PyCubed-Mini/kicad-libs/README.md

# kicad-libs
KiCad libraries for REx Lab avionics
