PyCubed-Mini/kicad-libs/3d/OV5640-A Camera.step

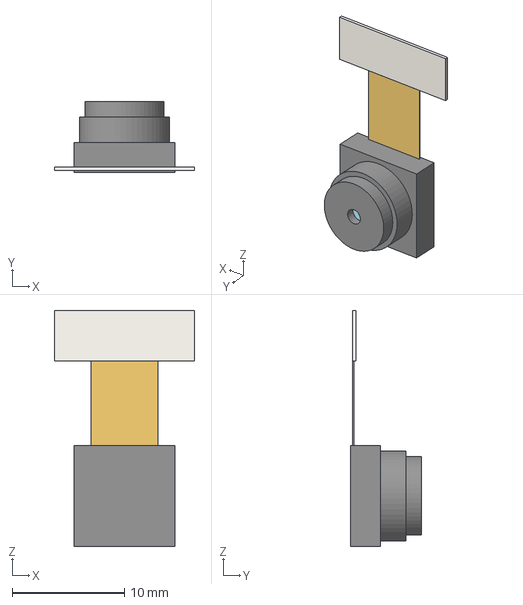
[picture p1: CAD file, 2023-06-18]
3d/OV5640-A Camera.step
12.5 x 6.32 x 21.0 mm
