PyCubed-Mini/kicad-libs/3d/SM141K05TF.step

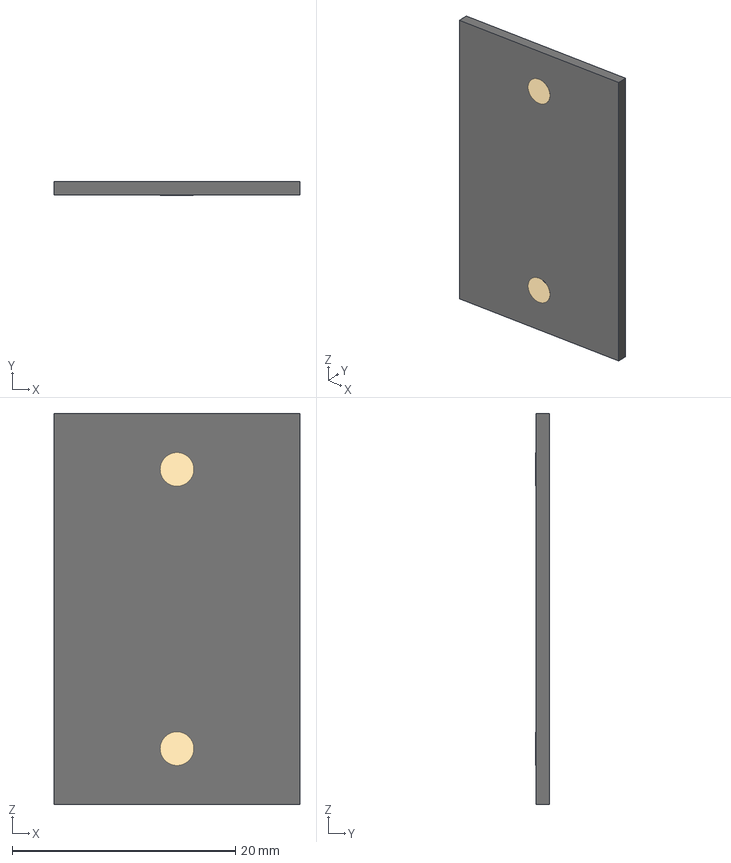
[picture p2: CAD file, 2023-05-28]
3d/SM141K05TF.step
22.0 x 1.22 x 35.0 mm
