PyCubed-Mini/kicad-libs/3d/SOT-583.stp

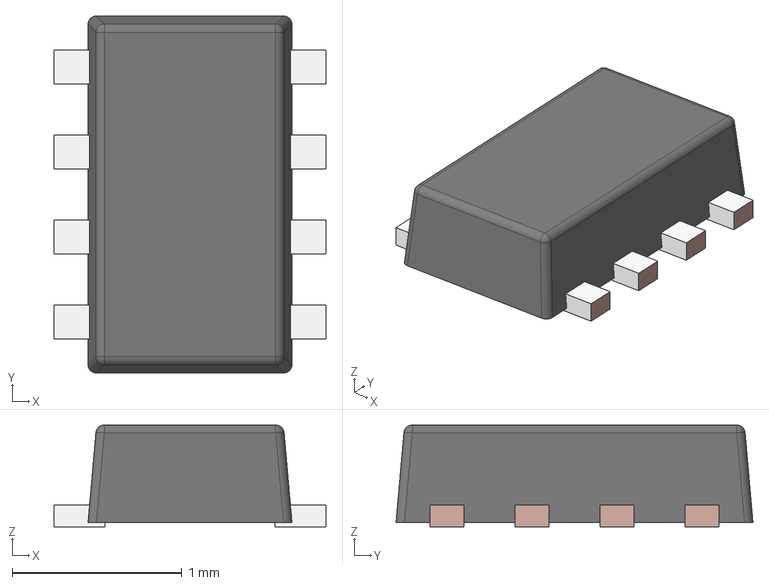
[picture p3: CAD file, 2023-05-28]
3d/SOT-583.stp
1.60 x 2.10 x 0.6 mm
FRAME-DRL0008A
BODY-SOT
