PyCubed-Mini/kicad-libs/3d/SM101K07L v1.step

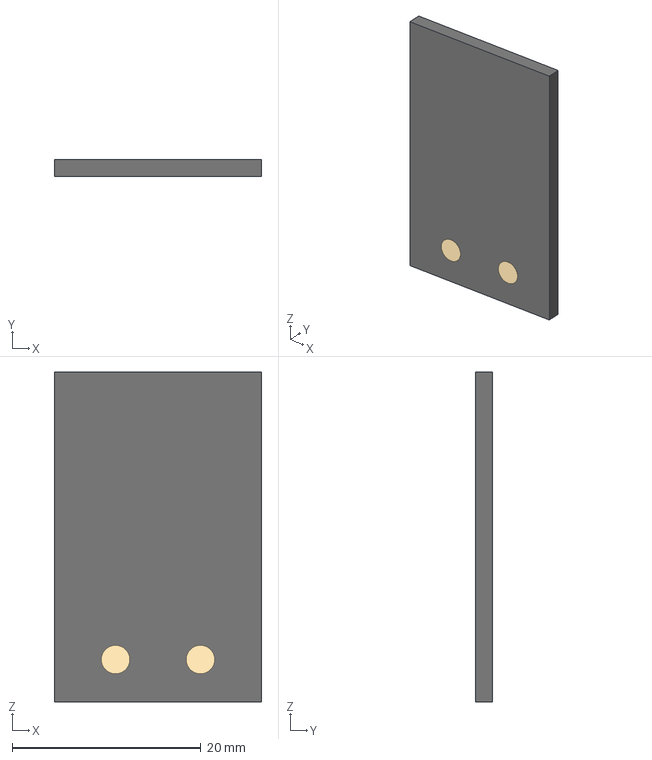
[picture p4: CAD file, 2023-05-28]
3d/SM101K07L v1.step
22.0 x 1.82 x 35.0 mm
