PyCubed-Mini/kicad-libs/3d/SM141K10LV v1.step

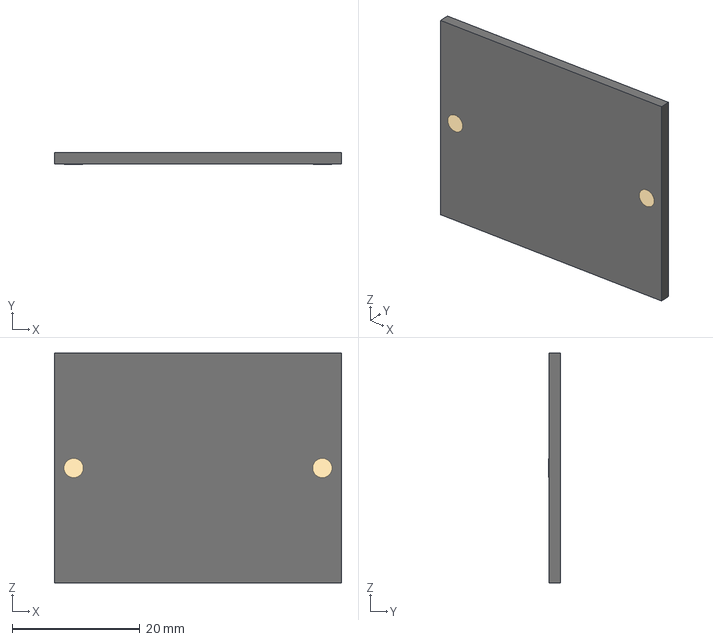
[picture p5: CAD file, 2023-05-28]
3d/SM141K10LV v1.step
45.0 x 1.82 x 36.0 mm
