PyCubed-Mini/kicad-libs/3d/Micro SD Card.STEP

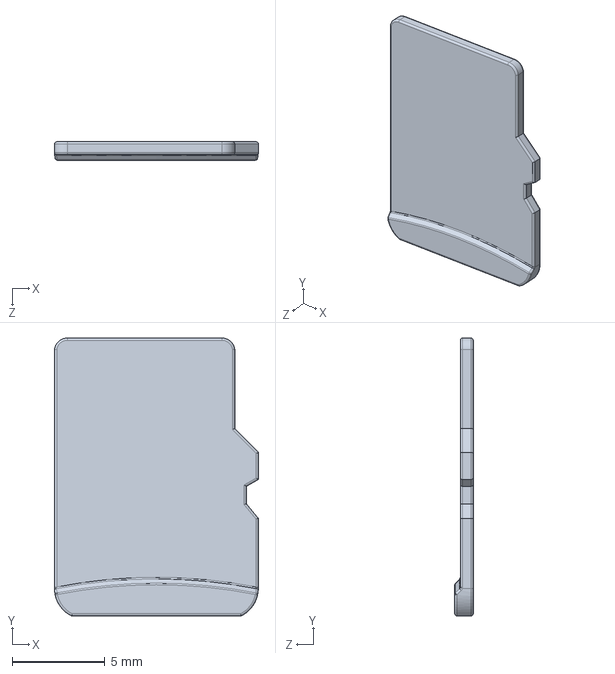
[picture p6: CAD file, 2023-02-25]
3d/Micro SD Card.STEP
11.0 x 15.0 x 1.00 mm
