PyCubed-Mini/kicad-libs/3d/OPT3001.step

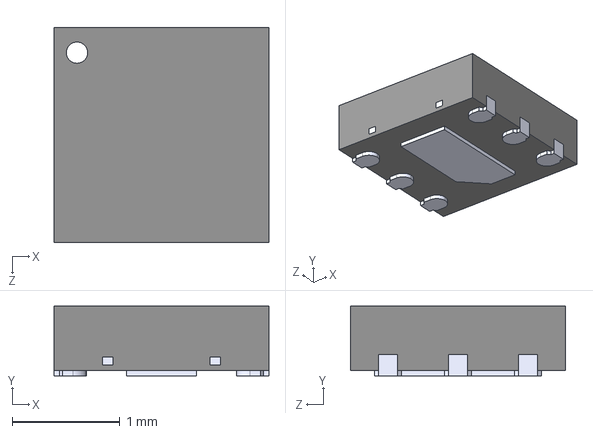
[picture p7: CAD file, 2023-02-25]
3d/OPT3001.step
2.00 x 0.65 x 2.00 mm
