PyCubed-Mini/kicad-libs/3d/BH1750FVI-TR.stp

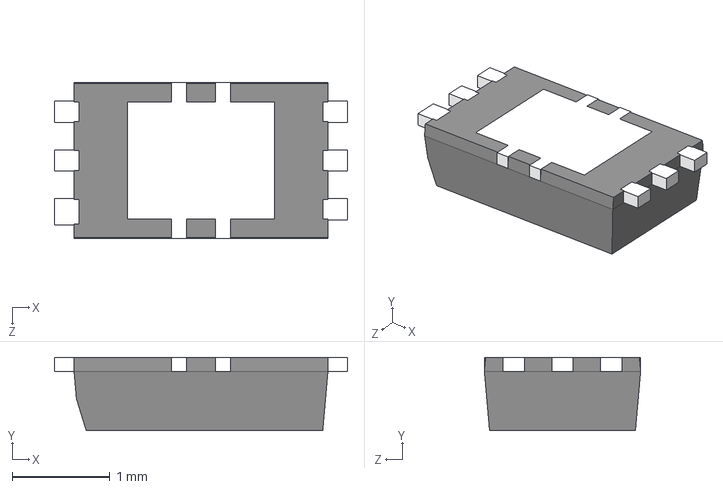
[picture p9: CAD file, 2023-02-19]
3d/BH1750FVI-TR.stp
3.00 x 0.75 x 1.60 mm
