PyCubed-Mini/kicad-libs/3d/SK6812-SIDE.step

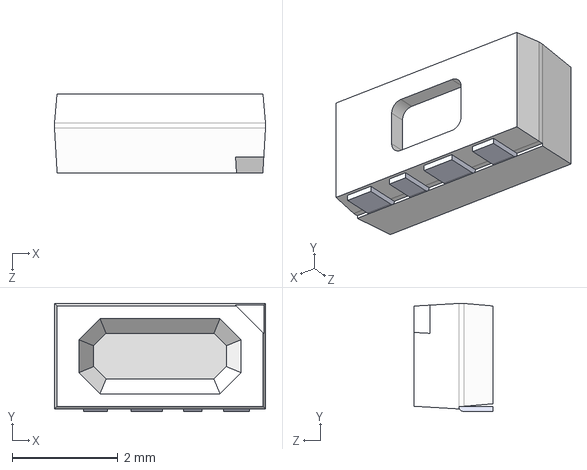
[picture p10: CAD file, 2023-02-18]
3d/SK6812-SIDE.step
4.00 x 2.05 x 1.50 mm
