PyCubed-Mini/kicad-libs/3d/KMS2.STEP

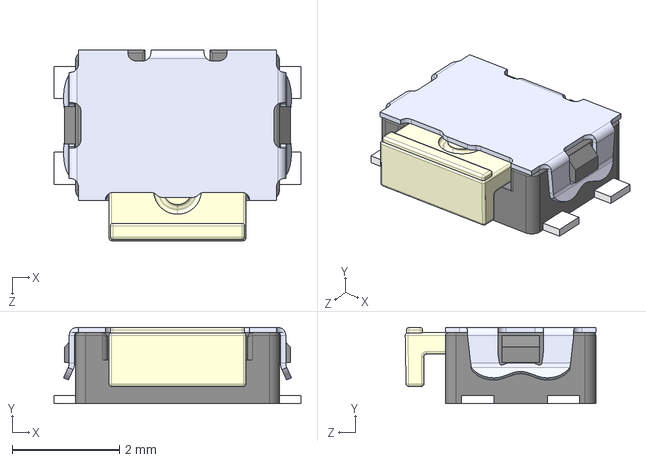
[picture p11: CAD file, 2023-02-18]
3d/KMS2.STEP
4.60 x 1.42 x 3.55 mm
