PyCubed-Mini/kicad-libs/3d/BNO085.step

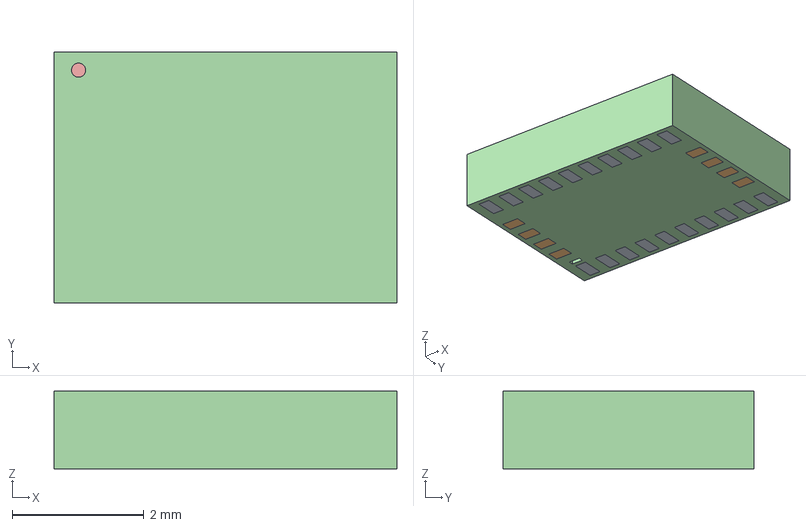
[picture p12: CAD file, 2023-02-18]
3d/BNO085.step
5.20 x 3.80 x 1.18 mm
