PyCubed-Mini/kicad-libs/3d/OV5640 Camera v1.step

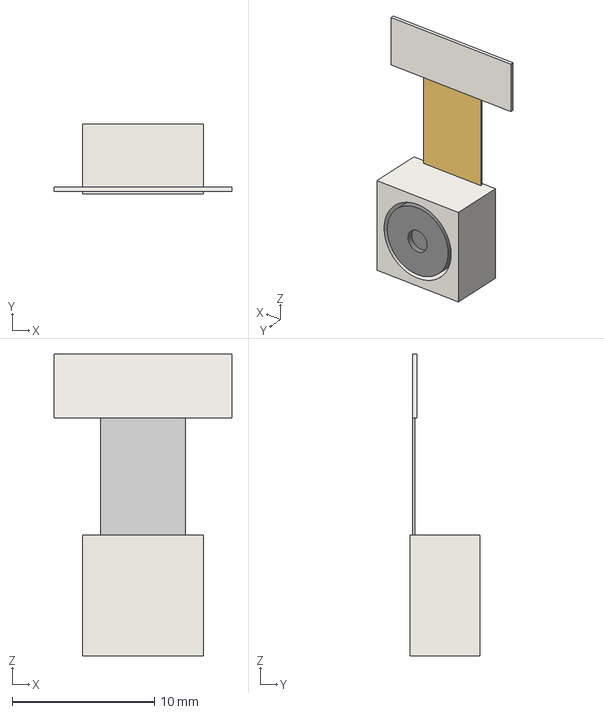
[picture p13: CAD file, 2023-02-09]
3d/OV5640 Camera v1.step
12.5 x 4.95 x 21.2 mm
