PyCubed-Mini/kicad-libs/3d/Crystal_4pin_2520.STEP

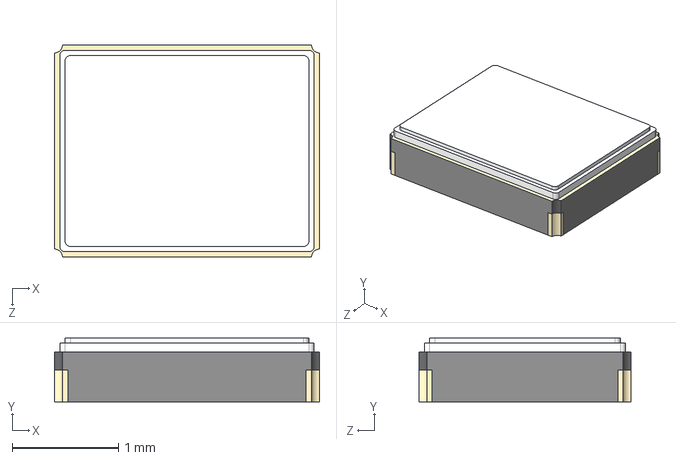
[picture p14: CAD file, 2023-02-08]
3d/Crystal_4pin_2520.STEP
2.50 x 0.6 x 2.00 mm
