PyCubed-Mini/kicad-libs/3d/CAS-120TA.stp

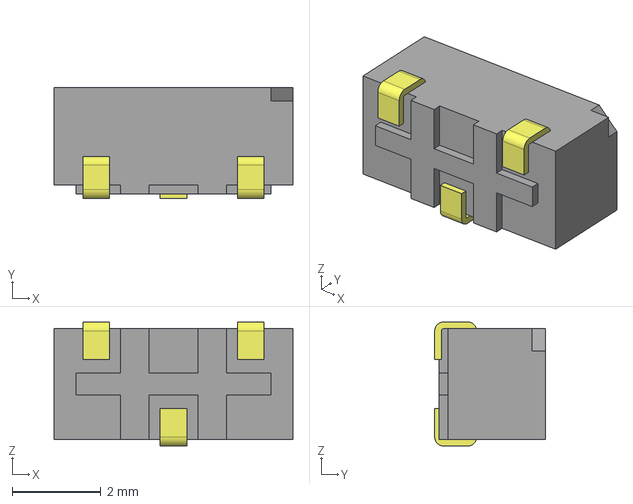
[picture p15: CAD file, 2023-02-08]
3d/CAS-120TA.stp
5.40 x 2.50 x 2.80 mm
1 pole_s
CAS_c_12A
