PyCubed-Mini/kicad-libs/3d/FTS-105-01-X-DV-A.stp

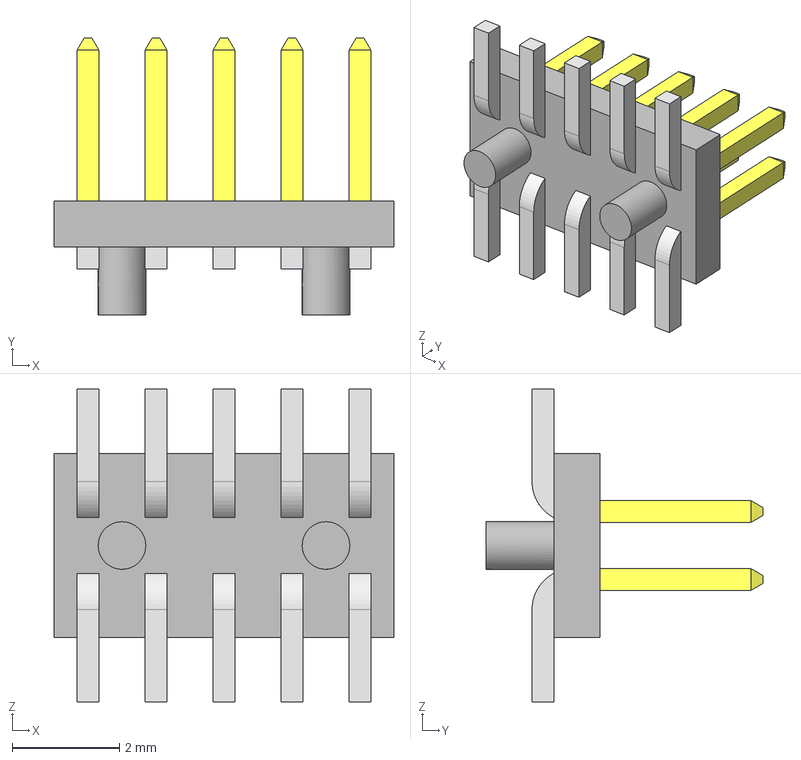
[picture p16: CAD file, 2022-11-09]
3d/FTS-105-01-X-DV-A.stp
6.35 x 5.18 x 5.84 mm
FTS-105-01-L-DV-A_pins2
FTS-105-01-L-DV-A_pins1
FTS-105-01-L-DV-A_body
