PyCubed-Mini/kicad-libs/3d/B3U-3000P.STEP

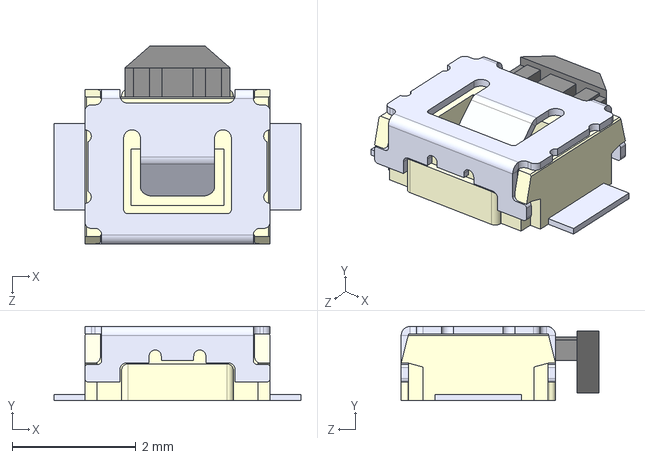
[picture p17: CAD file, 2022-11-09]
3d/B3U-3000P.STEP
4.00 x 1.20 x 3.20 mm
