PyCubed-Mini/kicad-libs/3d/FLE-107-01-X-DV-A.stp

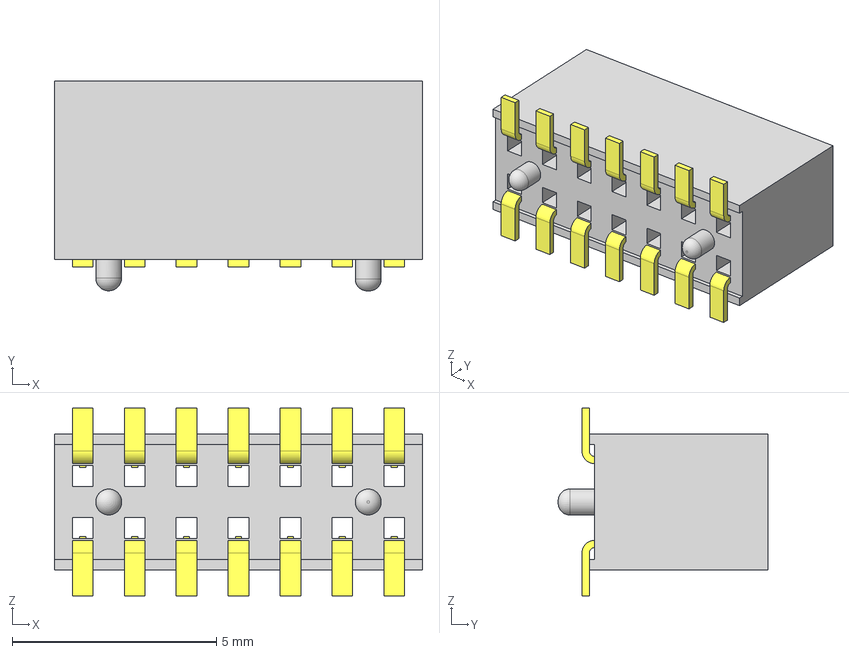
[picture p18: CAD file, 2022-10-09]
3d/FLE-107-01-X-DV-A.stp
9.00 x 5.13 x 4.59 mm
C-96-01-07-DV
FLE-107-01-DV-A_socket
