PyCubed-Mini/kicad-libs/3d/FTS-107-01-X-DV-A.stp

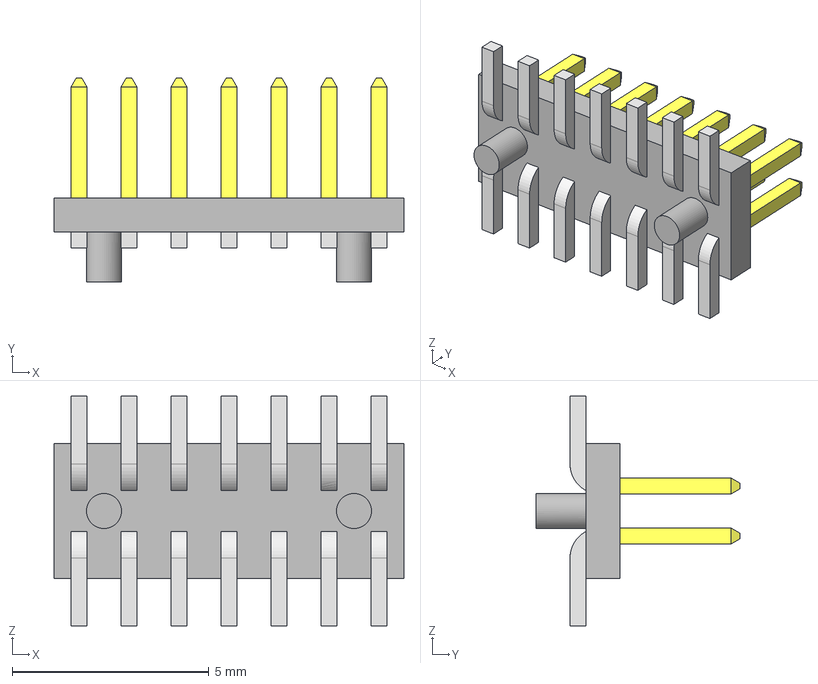
[picture p19: CAD file, 2022-10-09]
3d/FTS-107-01-X-DV-A.stp
8.89 x 5.18 x 5.84 mm
FTS-107-01-L-DV-A_pins2
FTS-107-01-L-DV-A_pins1
FTS-107-01-L-DV-A_body
