PyCubed-Mini/kicad-libs/3d/FTS-110-01-X-DV-A.stp

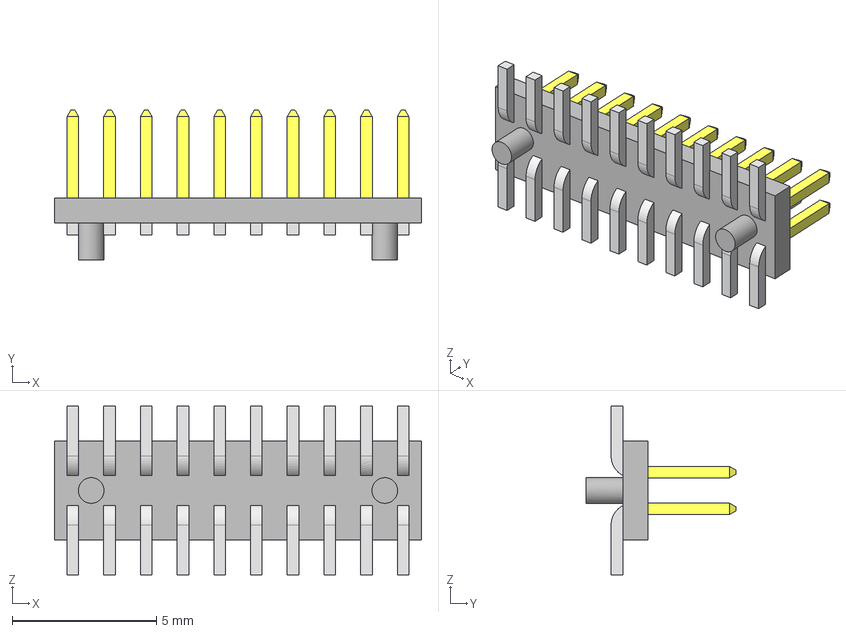
[picture p20: CAD file, 2022-08-21]
3d/FTS-110-01-X-DV-A.stp
12.7 x 5.18 x 5.84 mm
FTS-110-01-L-DV-A_pins2
FTS-110-01-L-DV-A_pins1
FTS-110-01-L-DV-A_body
