PyCubed-Mini/kicad-libs/3d/SFC-110-T2-X-D-A.step

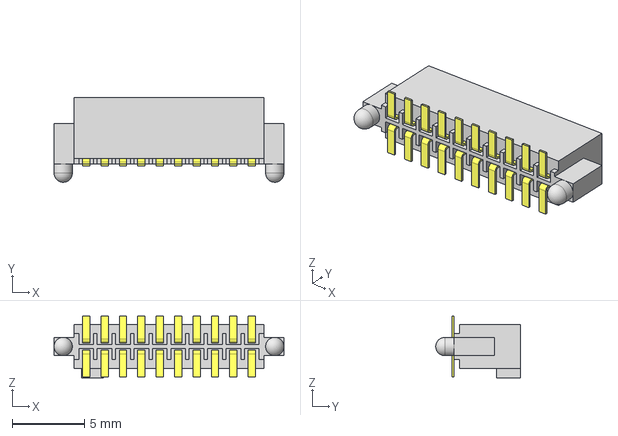
[picture p21: CAD file, 2022-08-20]
3d/SFC-110-T2-X-D-A.step
15.9 x 5.84 x 4.25 mm
C-119-T2-10_pins
SFC-110-T2-D-A_terminal
