PyCubed-Mini/kicad-libs/3d/LIS3MDLTR.step

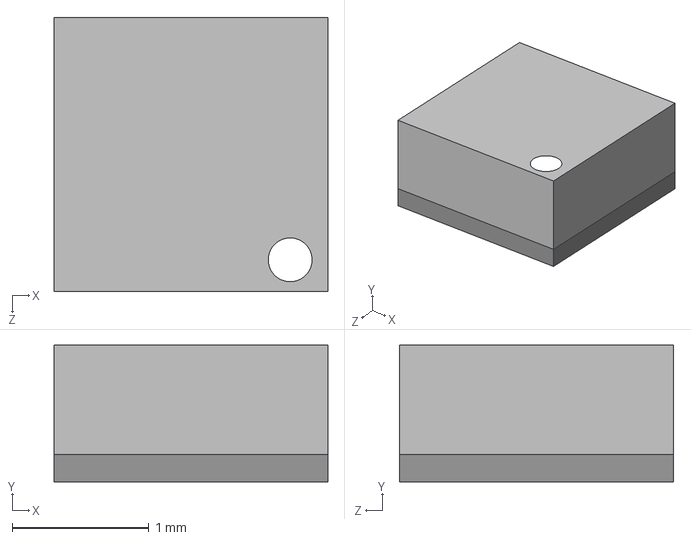
[picture p22: CAD file, 2022-08-20]
3d/LIS3MDLTR.step
2.00 x 1.00 x 2.00 mm
