PyCubed-Mini/kicad-libs/3d/LSM6DSOX.step

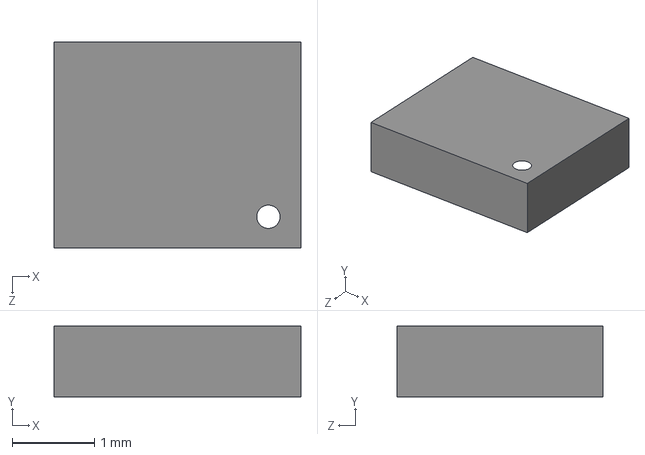
[picture p23: CAD file, 2022-08-20]
3d/LSM6DSOX.step
3.00 x 0.86 x 2.50 mm
