PyCubed-Mini/kicad-libs/3d/FTSH-110-01-X-DV-A.stp

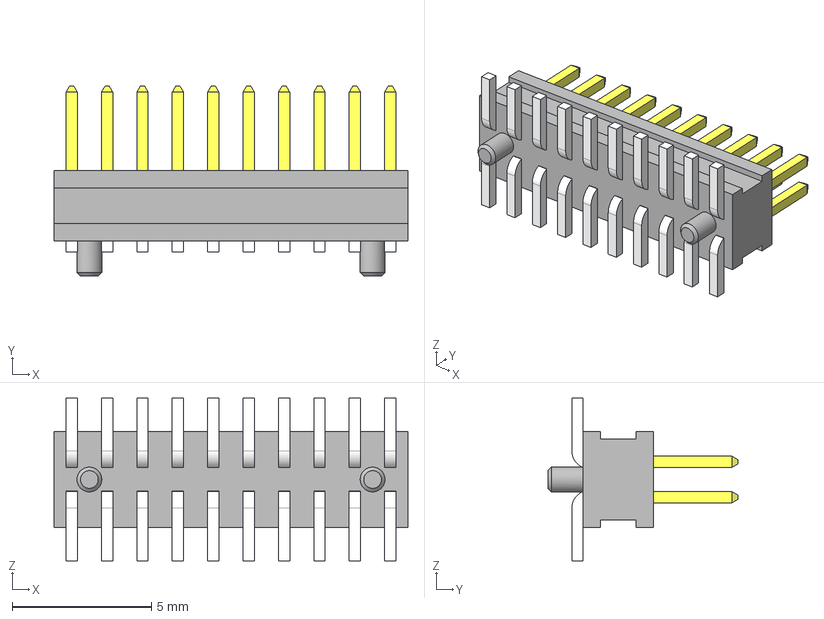
[picture p24: CAD file, 2022-08-20]
3d/FTSH-110-01-X-DV-A.stp
12.7 x 6.83 x 5.84 mm
FTSH-110-01-L-DV-A_pins2
FTSH-110-01-L-DV-A_pins1
FTSH-110-01-L-DV-A_body
