PyCubed-Mini/kicad-libs/3d/CLP-105-02-X-DH-A.stp

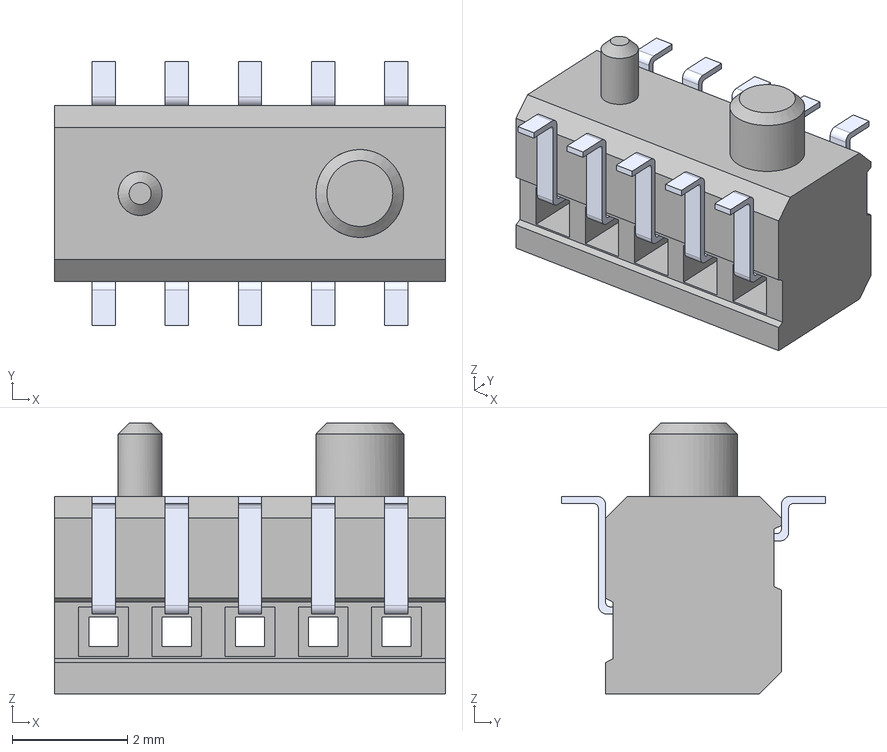
[picture p25: CAD file, 2022-08-20]
3d/CLP-105-02-X-DH-A.stp
6.78 x 4.57 x 4.70 mm
C-70-05-105-A_Pin_dh
C-70-04-105_Pin_2_dh
CLP-105-2-F-DH-A_terminal
