PyCubed-Mini/kicad-libs/3d/FLE-110-01-X-DV-A.step

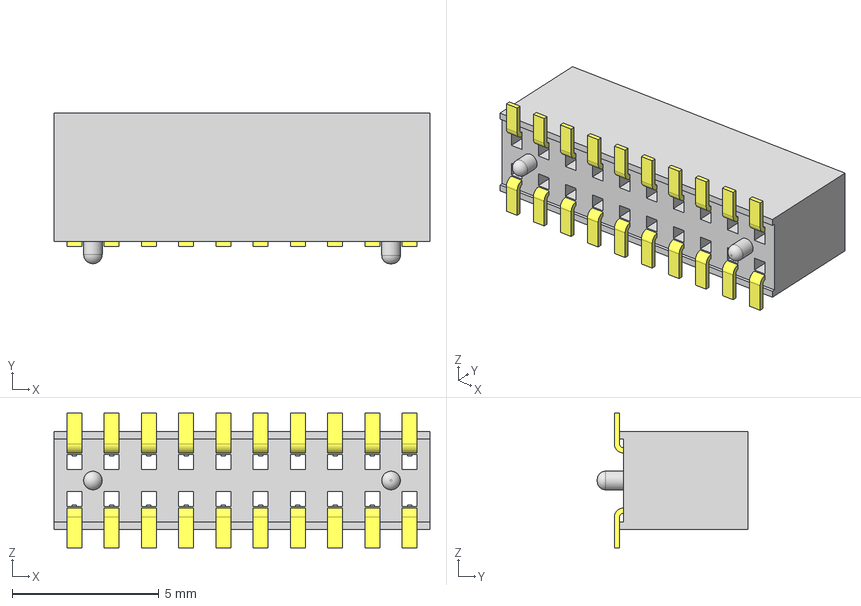
[picture p26: CAD file, 2022-08-20]
3d/FLE-110-01-X-DV-A.step
12.8 x 5.13 x 4.59 mm
C-96-01-10-DV
FLE-110-01-DV-A_socket
