PyCubed-Mini/kicad-libs/3d/BM02B-SRSS-TB.STEP

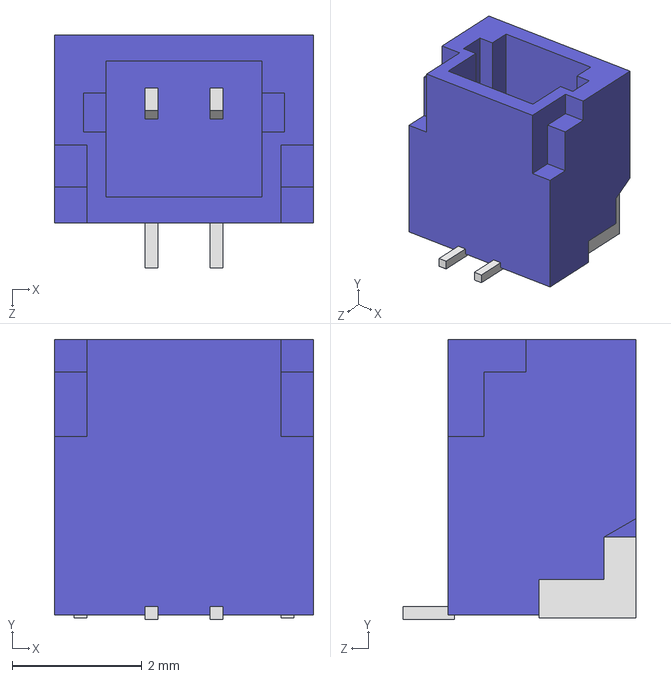
[picture p27: CAD file, 2022-07-05]
3d/BM02B-SRSS-TB.STEP
4.00 x 4.32 x 3.60 mm
