PyCubed-Mini/kicad-libs/3d/D2F_L2_A.step

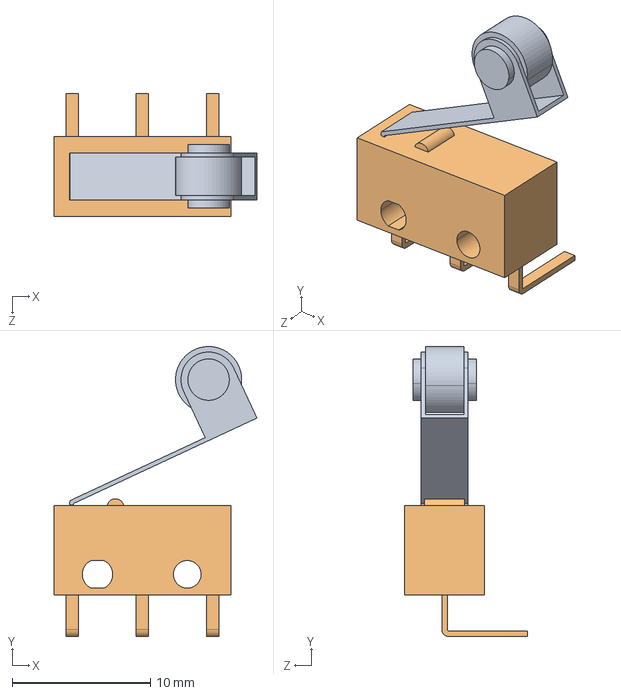
[picture p28: CAD file, 2022-07-04]
3d/D2F_L2_A.step
14.7 x 21.0 x 8.90 mm
D2F_L2_A_ACTUATOR
D2F_L2_A_BASE
