PyCubed-Mini/kicad-libs/3d/FLE-105-01-X-DV-A.step

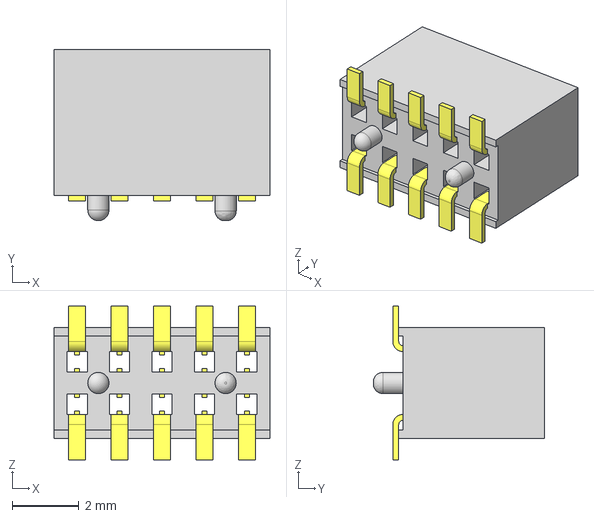
[picture p29: CAD file, 2022-06-29]
3d/FLE-105-01-X-DV-A.step
6.46 x 5.13 x 4.59 mm
_FLE-105-01-DV-A_socket
_C-96-01-05-DV
