PyCubed-Mini/kicad-libs/3d/TFM-110-12-X-D-A.stp

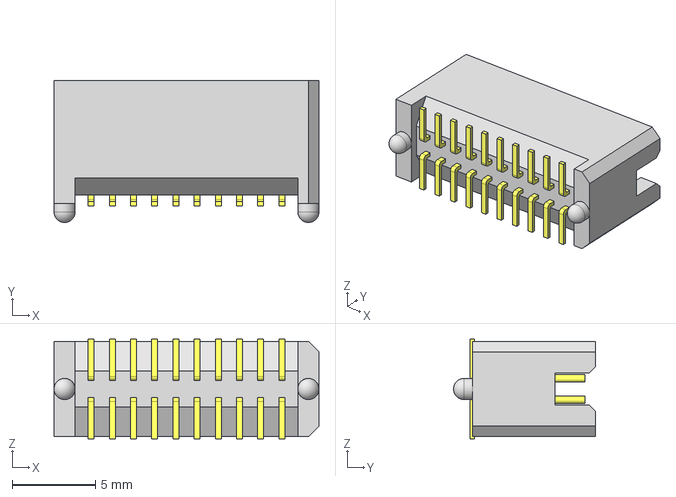
[picture p30: CAD file, 2022-06-08]
3d/TFM-110-12-X-D-A.stp
15.9 x 8.51 x 5.97 mm
_TFM-110-12-L-D-A_terminal
_TFM-110-12-L-D_pins
