PyCubed-Mini/kicad-libs/3d/PCM12SMTR.step

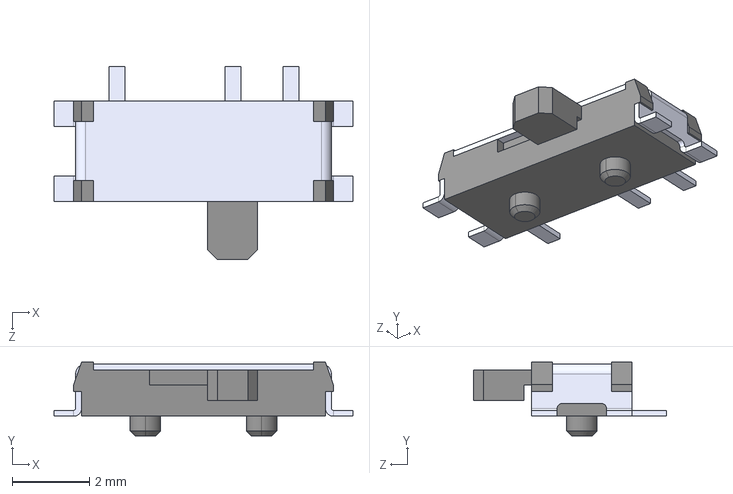
[picture p31: CAD file, 2022-06-08]
3d/PCM12SMTR.step
7.72 x 1.91 x 4.98 mm
