PyCubed-Mini/kicad-libs/3d/SFMC-110-01-X-D.stp

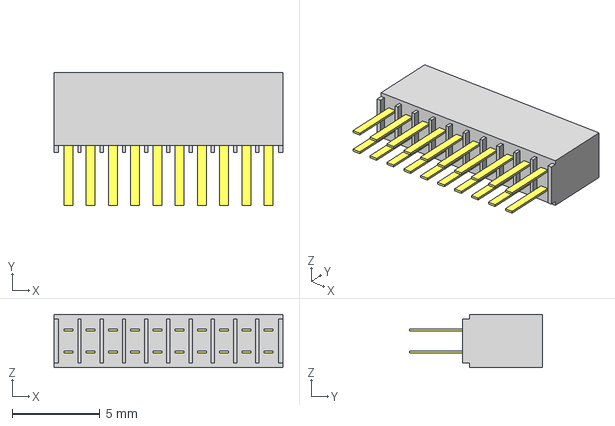
[picture p32: CAD file, 2022-06-08]
3d/SFMC-110-01-X-D.stp
13.1 x 7.62 x 3.05 mm
_SFMC-110-01_socket
_C-10-01_spins
