PyCubed-Mini/kicad-libs/3d/HRO_TYPE-C-31-M-12.step

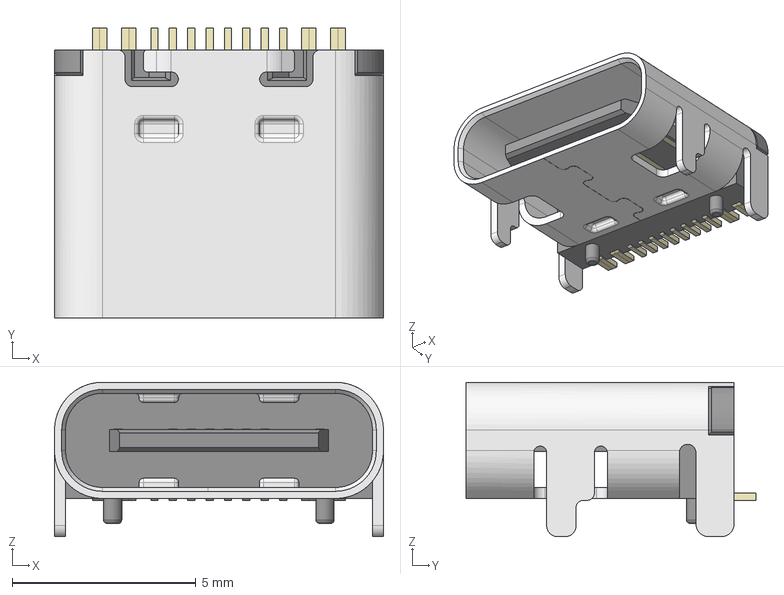
[picture p33: CAD file, 2022-05-17]
3d/HRO_TYPE-C-31-M-12.step
8.95 x 7.90 x 4.20 mm
