PyCubed-Mini/kicad-libs/3d/KMR221GLF.STEP

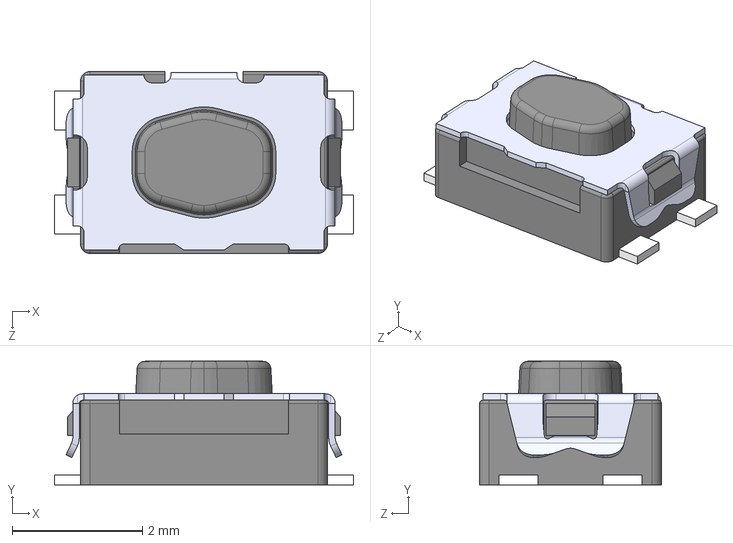
[picture p34: CAD file, 2022-05-14]
3d/KMR221GLF.STEP
4.60 x 1.90 x 2.80 mm
