PyCubed-Mini/kicad-libs/3d/nicla_vision.step

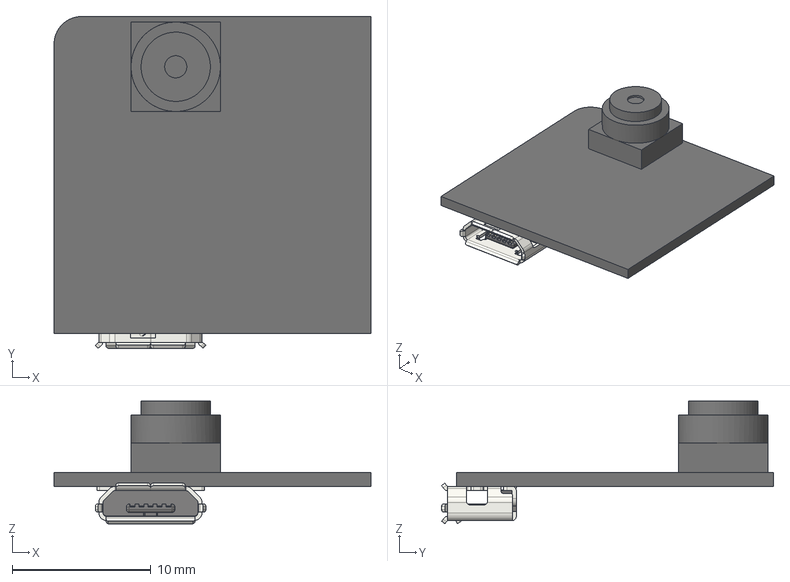
[picture p35: CAD file, 2022-03-25]
3d/nicla_vision.step
22.9 x 23.9 x 8.84 mm
