PyCubed-Mini/kicad-libs/3d/B2B-PH-SM4-TB(LF)(SN).STEP

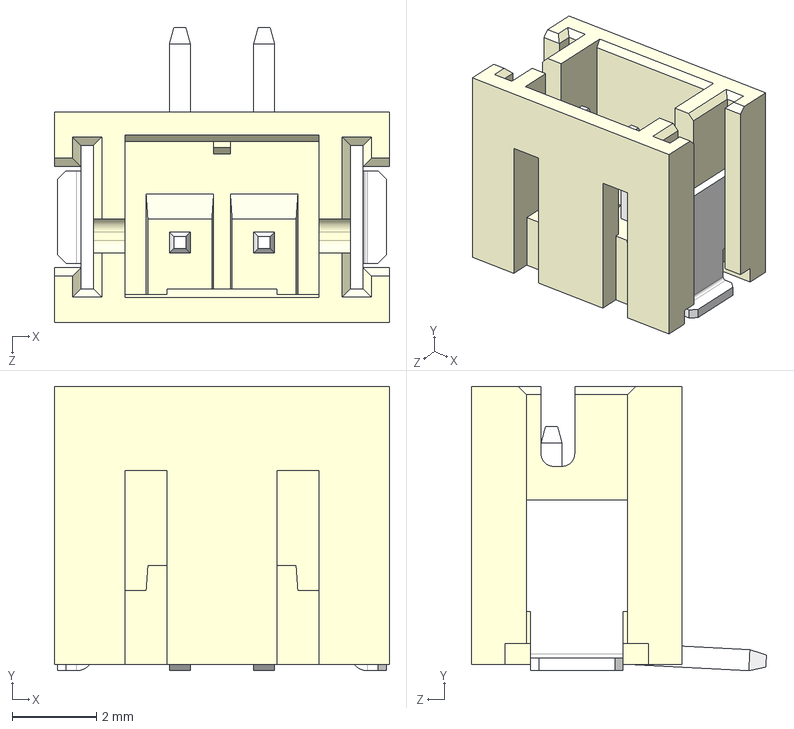
[picture p36: CAD file, 2022-03-14]
3d/B2B-PH-SM4-TB(LF)(SN).STEP
7.95 x 6.75 x 7.00 mm
