PyCubed-Mini/kicad-libs/3d/ATB2012-50011-T000.stp

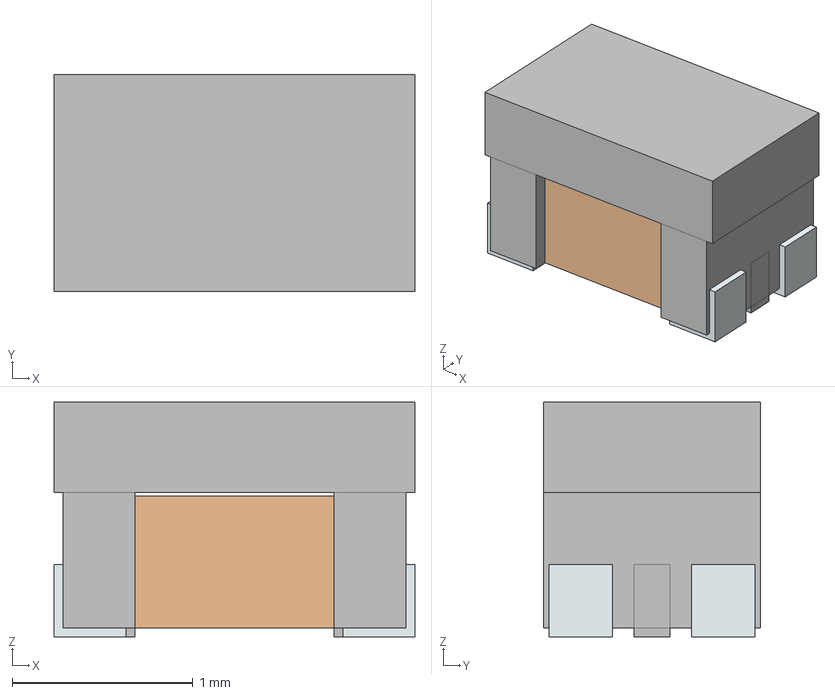
[picture p37: CAD file, 2022-03-14]
3d/ATB2012-50011-T000.stp
2.00 x 1.20 x 1.30 mm
solidBody
solidLead
solidCoil
