PyCubed-Mini/kicad-libs/3d/POWERDI-123.STEP

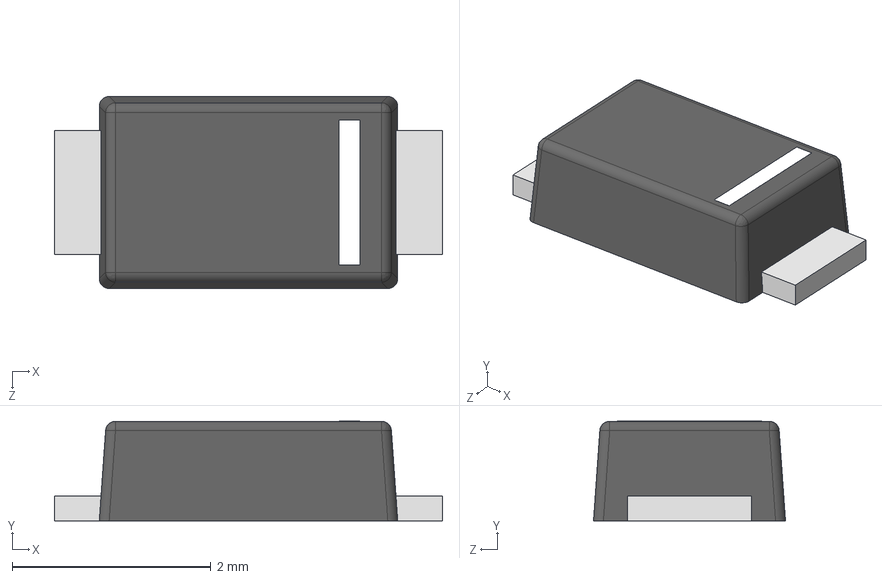
[picture p38: CAD file, 2022-03-14]
3d/POWERDI-123.STEP
3.90 x 1.00 x 1.93 mm
