PyCubed-Mini/kicad-libs/3d/MSS1P4-M3-89A.step

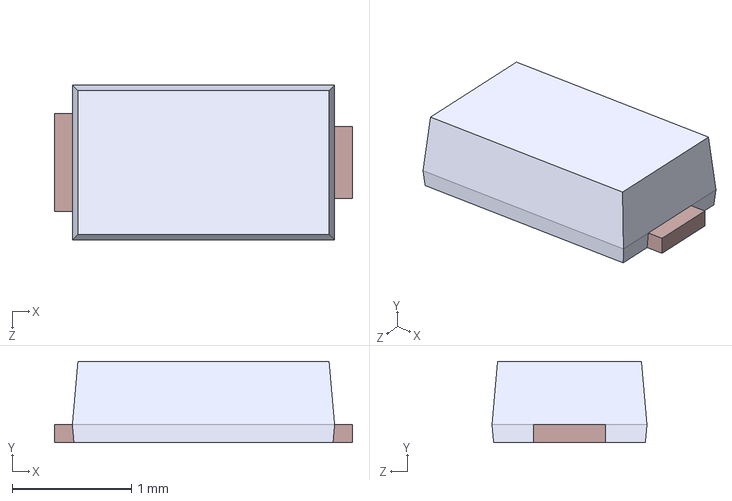
[picture p39: CAD file, 2022-03-14]
3d/MSS1P4-M3-89A.step
2.50 x 0.68 x 1.30 mm
