PyCubed-Mini/kicad-libs/3d/Coilcraft-LPS4018.step

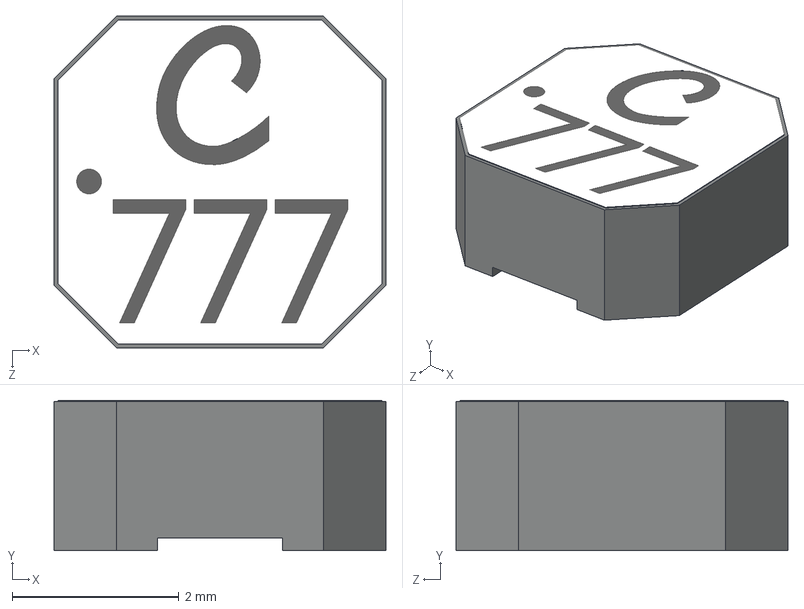
[picture p40: CAD file, 2022-03-14]
3d/Coilcraft-LPS4018.step
3.98 x 1.80 x 3.98 mm
