PyCubed-Mini/kicad-libs/3d/RFM98PW.step

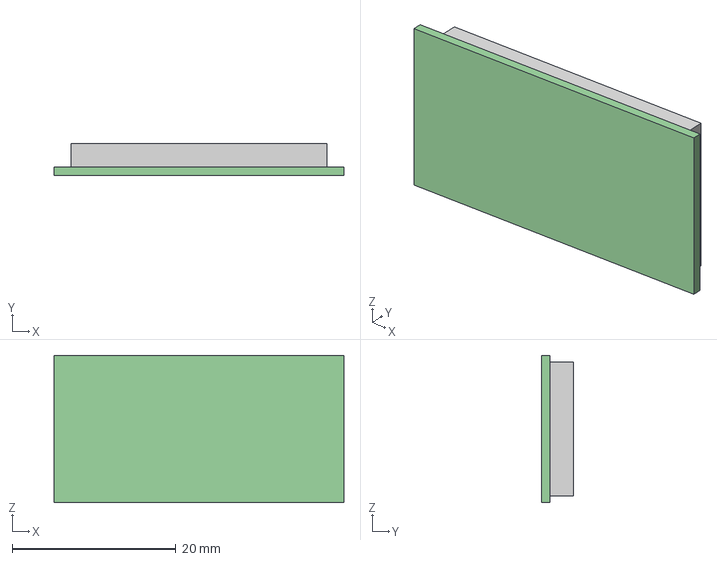
[picture p41: CAD file, 2022-03-04]
3d/RFM98PW.step
35.4 x 3.85 x 18.0 mm
