PyCubed-Mini/kicad-libs/3d/TSL2561.stp

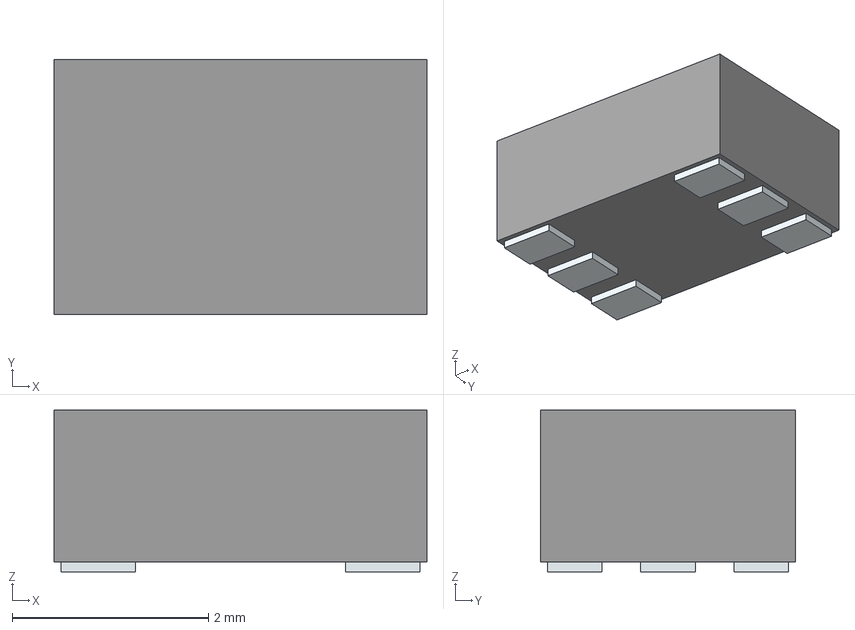
[picture p42: CAD file, 2020-02-20]
3d/TSL2561.stp
3.80 x 2.60 x 1.65 mm
('pin',_'1')
('pin',_'2')
('pin',_'3')
('pin',_'4')
('pin',_'5')
('pin',_'6')
