PyCubed-Mini/kicad-libs/3d/U.FL-R-SMT-1.stp

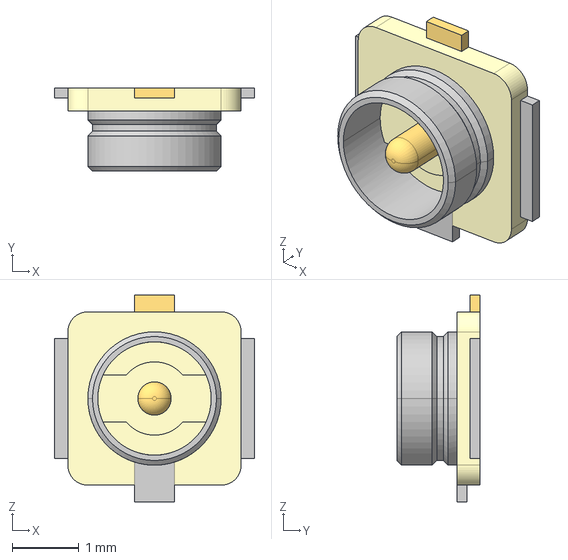
[picture p43: CAD file, 2020-02-20]
3d/U.FL-R-SMT-1.stp
3.00 x 1.25 x 3.10 mm
