PyCubed-Mini/kicad-libs/3d/SRF2012.step

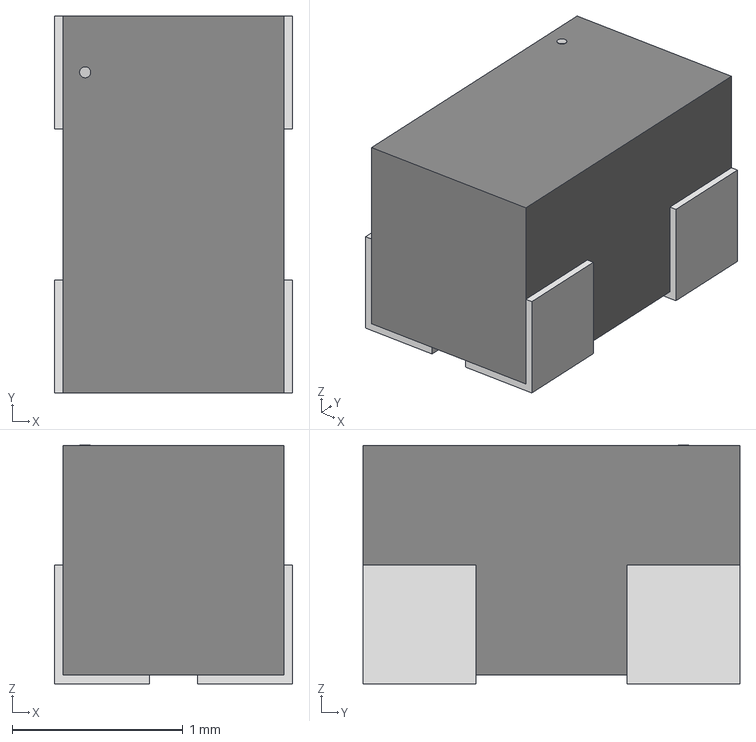
[picture p44: CAD file, 2020-02-20]
3d/SRF2012.step
1.40 x 2.21 x 1.40 mm
