PyCubed-Mini/kicad-libs/3d/SolarCell.STEP

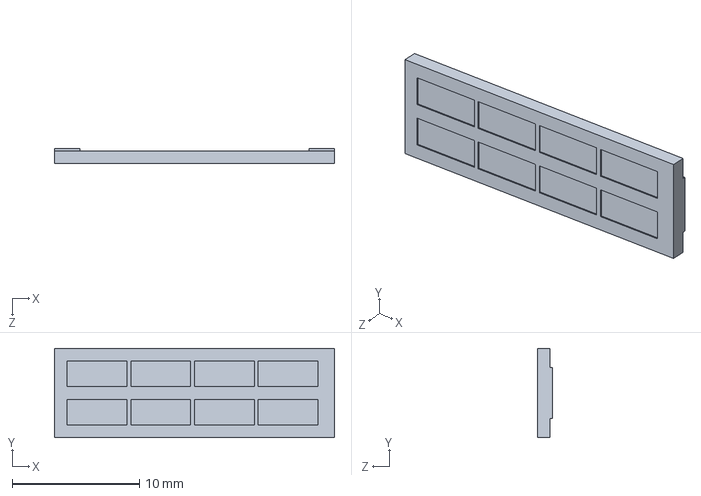
[picture p45: CAD file, 2020-02-20]
3d/SolarCell.STEP
22.0 x 7.00 x 1.20 mm
