PyCubed-Mini/kicad-libs/3d/BMX160.stp

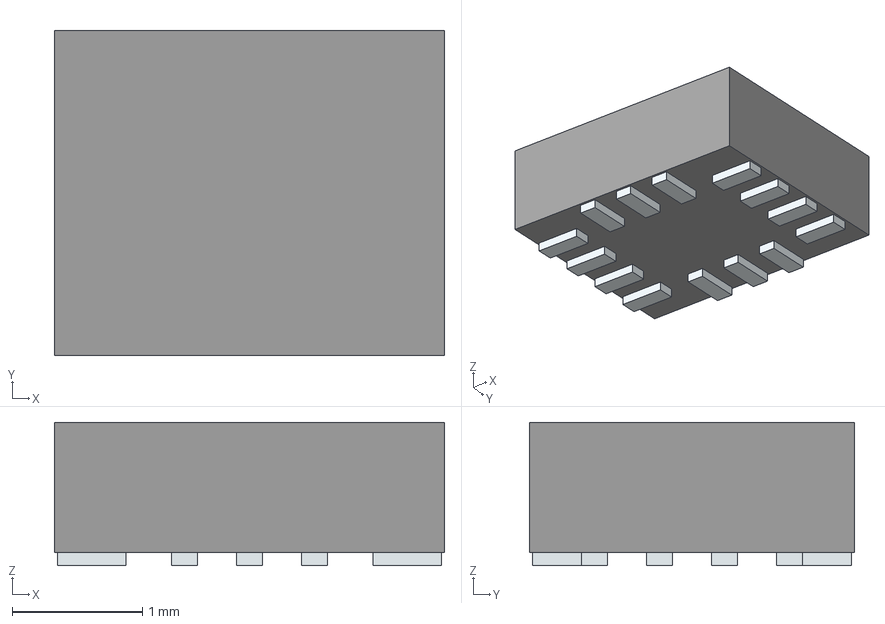
[picture p46: CAD file, 2020-02-20]
3d/BMX160.stp
3.00 x 2.50 x 1.10 mm
('pin',_'1')
('pin',_'2')
('pin',_'3')
('pin',_'4')
('pin',_'5')
('pin',_'6')
('pin',_'7')
('pin',_'8')
('pin',_'9')
('pin',_'10')
('pin',_'11')
('pin',_'12')
('pin',_'13')
('pin',_'14')
