PyCubed-Mini/kicad-libs/3d/DRV8848PWPR.stp

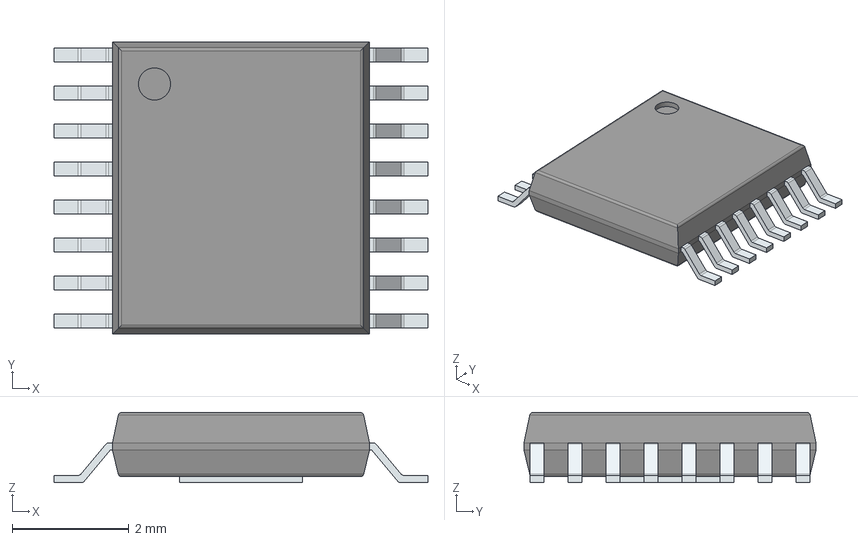
[picture p47: CAD file, 2020-02-20]
3d/DRV8848PWPR.stp
6.40 x 5.00 x 1.20 mm
PinsArrayLR
ThermalPad
