PyCubed-Mini/kicad-libs/3d/SK6812-MINI.step

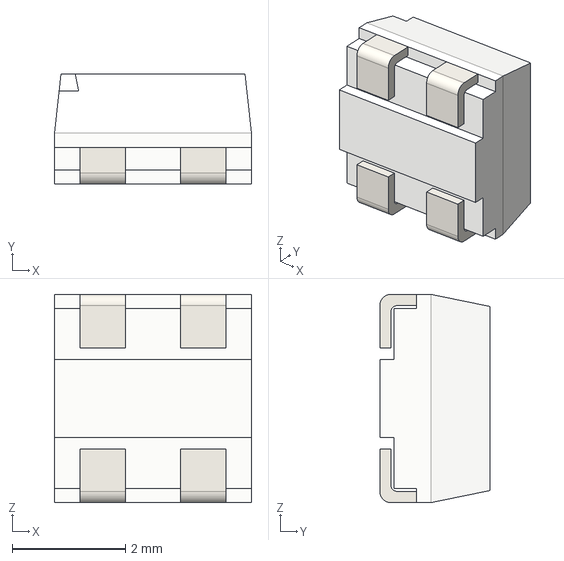
[picture p48: CAD file, 2020-02-20]
3d/SK6812-MINI.step
3.48 x 1.95 x 3.68 mm
