PyCubed-Mini/kicad-libs/(list of files, cad)

Other CAD files:
3d/D2F_L2_A1.step
3d/1040310811.stp
3d/150141M173100 (rev1).stp
3d/434331045822.stp
3d/503182-1852.step
3d/5051102491.stp
3d/BQ25570RGRR.stp
