PyCubed-Mini/kicad-libs/(commit log)

2020-02-20 migrated 3d models
    [10118194.STEP, 10118194c.stp, 146168-0001.stp, 5031821852.STEP, 732513140_SMA.step, 734152061_MMCX.step, 734152063.stp, AP.10H.01_GPS.step]
2020-02-23 added 2.4GHz antenna
2022-03-04 Added Pin Header and SD Card Receptacle
    [1040310811.stp, 851-91-005-20-001000.STEP]
2022-03-04 RFM98PW step file
    [RFM98PW.step]
2022-03-12 Added XF3M-2415-1B Step model
    [XF3M_2415_1B.stp]
2022-03-13 Added GCT-FFC2B2824G Step model
    [FFC2B28-24-G.stp]
2022-03-13 Moved in mainboard libraries
    [XF2M36151A.stp, XF3M_1_0615_1B.stp, XF3M_2415_1B.stp]
2022-03-14 Added Libs from mainboard and solar panels
    [10118194.STEP, 10118194c.stp, 1040310811.stp, 146168-0001.stp, 5031821852.STEP, 732513140_SMA.step, 734152061_MMCX.step, 734152063.stp]
2022-03-24 Add cameraboard libs
    [UFM.step]
2022-03-24 Added connector symbols
2022-03-25 Added Nicla board model
    [nicla_vision.step]
2022-05-14 New mainboard parts
    [15250082601000.stp, 15250102601000.stp, 503398-1892.step, KMR221GLF.STEP, USB4105-15-A-120.stp]
2022-05-16 Added M3 Mounting Holes
2022-05-17 Replace USB-C model
    [HRO_TYPE-C-31-M-12.step, USB4105-15-A-120.stp]
2022-06-02 Moved SD card to cameraboard library
2022-06-03 Added battery board footprint library
2022-06-08 New stack connectors and SPDT switch
    [PCM12SMTR.step, SFMC-110-01-L-D.stp, SLM-110-01-G-S.stp]
2022-06-08 Added cameraboard stack connectors
    [FLE-105-01-G-DV-A.step, TFM-110-12-L-D-A.stp]
2022-06-10 Batteryboard components
    [FTS-105-01-L-DV-A-P.stp, TMS-110-01-G-S.step]
2022-06-24 New Mainboard-Solar Panels X/Z Connectors added
    [SFMH-105-02-L-D-LC.step, SFMH-105-02-L-D-WT.step]
2022-06-29 Fixed Pin Numbering
2022-06-29 Fix Broken Model
    [FLE-105-01-G-DV-A.step]
2022-07-01 Updated Nicla footprint
2022-07-04 Fixed Y- Switch Models
    [D2F_L2_A.step]
2022-07-05 add vertical jst battery charging connector
    [BM02B-SRSS-TB.STEP]
2022-08-06 Updated Burn wire symbol
2022-08-20 New components for mainboard v05
    [10144517-041x0xlf.stp, 10144518-042x0xxx.stp, 528850374.stp, CLP-105-02-F-DH-A.stp, FLE-110-01-G-DV-A.step, FTSH-110-01-L-DV-A.stp, LIS3MDLTR.step, LSM6DSOXTR.step]
2022-08-21 New components for batteryboards v02
    [FTS-110-01-L-DV-A.stp]
2022-09-02 Resized pads on solar panel connectors
2022-09-02 Fixed Deployment Switch Pin Numbers
2022-09-03 New Antenna Mount Footprint
2022-09-05 Updated BurnWire Footprint
2022-09-22 Added 3535 NeoPixel
    [SMD WS2812B Mini.step]
2022-09-26 SD Card Footprints
    [1040310811.stp, 528850374.stp]
2022-10-09 Added 7 pin connectors
    [FLE-107-01-G-DV-A.stp, FTS-107-01-L-DV-A.stp]
2022-10-09 Added 7 pin connector for payloadboard
2022-11-09 Updated 14 pin connector to have smaller pads
2022-11-09 Added right-angle reset switch
    [B3U-3000P--3DModel-STEP-56544.STEP]
2022-11-09 Updated 10 pin 3D model and Antenna Mount
    [FTS-105-01-L-DV-A-P.stp, FTS-105-01-L-DV-A.stp]
2022-11-10 Updated Antenna Mounting Hole
2022-11-11 Added Missing BMX160 Footprint to Library
2023-02-08 New Cameraboard components
    [150141M173100 (rev1).stp, 5051102491.stp, CAS-120TA.stp, Crystal_4pin_2520.STEP]
2023-02-09 Added Camera Model
    [OV5640 Camera v1.step]
2023-02-11 Added TSL2591 symbol and footprint
2023-02-18 Cleaned up some unused symbols / footprints
2023-02-18 Added BH1750
    [BH1750FVI-TR.stp]
2023-02-18 More cleanup
    [BNO085.step, CLP-105-02-X-DH-A.stp, FLE-110-01-X-DV-A.step, FTSH-110-01-X-DV-A.stp, KMS2.STEP, LSM6DSOX.step, SFC-110-T2-X-D-A.step, SFMC-110-01-X-D.stp]
2023-02-18 Added right-angle neopixel, and removed unused 3D models
    [10144517-041x0xlf.stp, 10144518-042x0xxx.stp, 15250082601000.stp, 15250102601000.stp, 503398-1892.step, B3U-3000P.STEP, FFC2B28-10-G.stp, FFC2B28-24-G.stp]
2023-02-19 Cleaned up cameraboard libs
2023-02-19 Cleaned up batteryboard libs
    [FLE-105-01-X-DV-A.step, FLE-107-01-X-DV-A.stp, FTS-105-01-X-DV-A.stp, FTS-107-01-X-DV-A.stp, FTS-110-01-X-DV-A.stp]
2023-02-19 Auto stash before merge of "master" and "origin/master"
    [BH1750FVI.STEP]
2023-02-22 cameraboard library update
2023-02-25 Added OPT3001 light sensor models
    [OPT3001.step]
2023-02-25 Added micro SD Card model
    [Micro SD Card.STEP]
2023-02-25 IMU footprint update
2023-03-02 Fixed Mounting hole via locations
2023-03-16 Updated Solar Panel Mounting Holes
2023-04-26 Added new reset button for mainboard
    [434331045822.stp]
2023-04-26 Updated Current Sense Resistor Footprint
2023-05-28 Added more solar panel models
    [SM101K07L v1.step, SM141K05TF.step, SM141K10LV v1.step, SOT-583.stp]
2023-06-18 Added Push-in push-out micro SD card connector models
    [503182-1852.step]
2023-06-18 Added new camera model
    [OV5640-A Camera.step]
2023-12-18 New IMU footprint
