PyCubed-Mini/kicad-libs/(notices)

Notices in the files:
3d/FTS-105-01-X-DV-A.stp:
author */ ('License CC BY-ND 4.0'),
3d/TFM-110-12-X-D-A.stp:
FILE_NAME( 'e:/temp/worker_215/temp/exporttempdir_6440_171_Y9UsK/format_0/TFM-110-12-L-D-A.stp', '2022-06-08T19:31:40', ( 'License CC BY-ND 4.0' ), ( 'CADENAS' ), ' ', 'PARTsolutions', ' ' );
3d/SFMC-110-01-X-D.stp:
FILE_NAME( 'e:/temp/worker_103/temp/exporttempdir_5440_31_kZQNd/format_0/SFMC-110-01-L-D.stp', '2022-06-08T01:03:42', ( 'License CC BY-ND 4.0' ), ( 'CADENAS' ), ' ', 'PARTsolutions', ' ' );
